cnxtech/TCDeadTimeDriver/README.md

# TCDeadTimeDriver

This repository contains a custom add-on circuit for the [oneTesla v1 Musical Tesla Coil](http://onetesla.com/) to add a Dead-Time between the gate pulses to the IGBT driver transistors to minimize overlap and prevent premature death of the transistors.
