cnxtech/TCDeadTimeDriver/PWMMainDriver.pdf

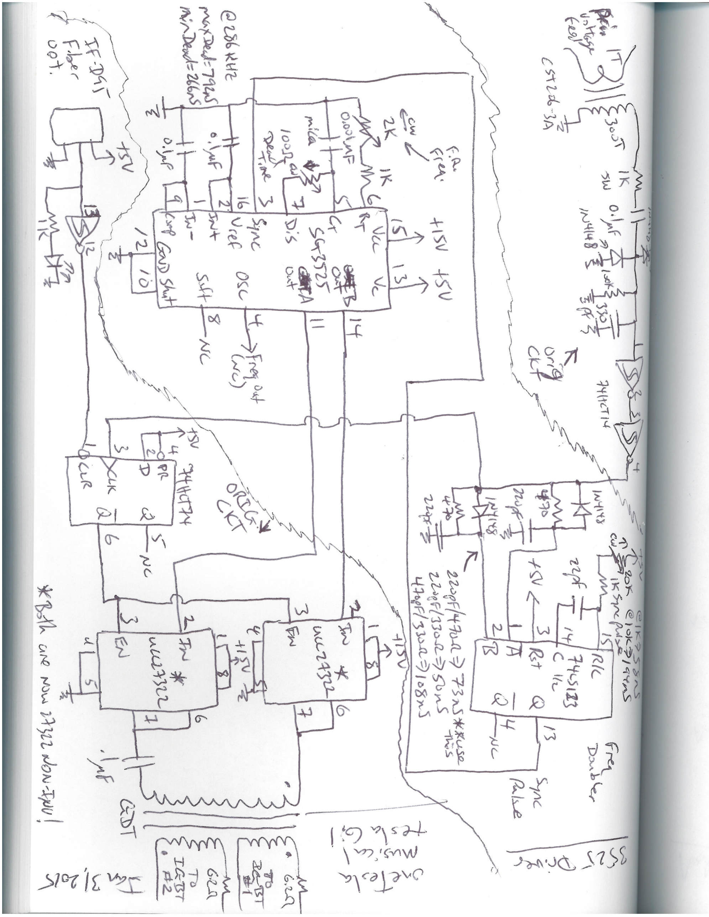
[picture p1: page 1]
