cnxtech/TCDeadTimeDriver/TCDeadTimeDriver-V1/preview/TCDeadTimeDriver-V1-00a-BoardTop.png

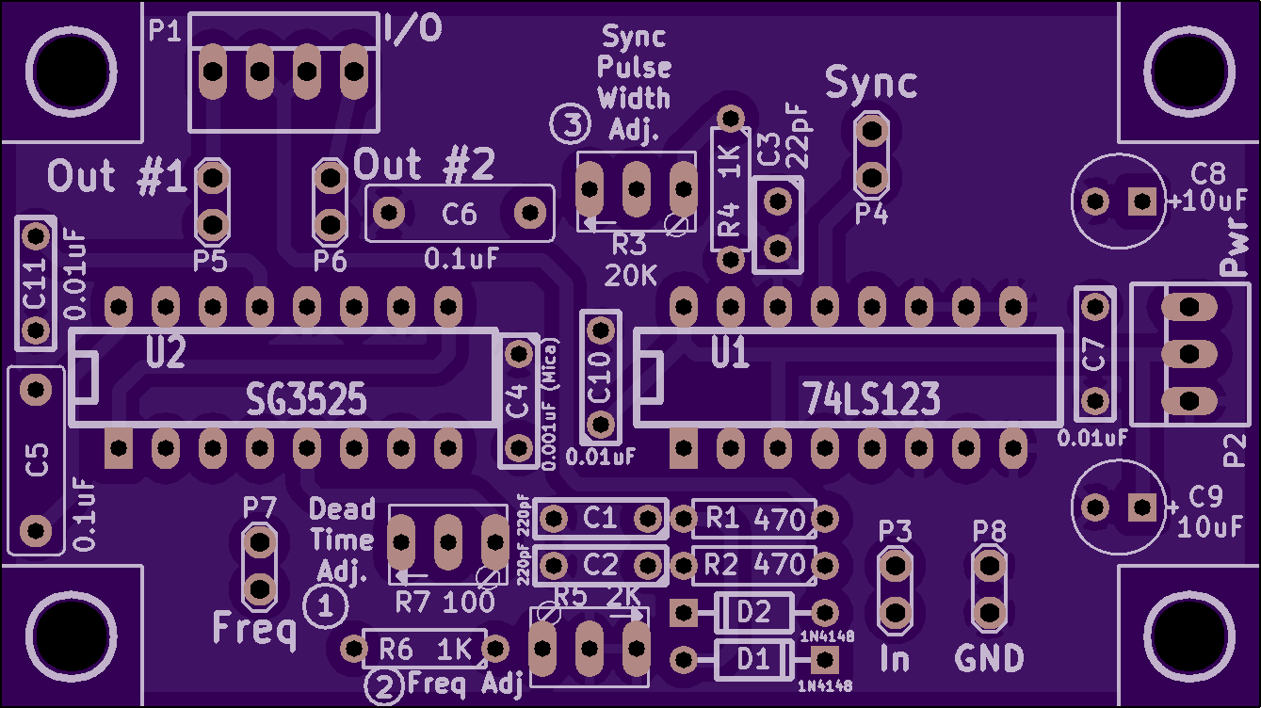
TCDeadTimeDriver-V1/preview/TCDeadTimeDriver-V1-00a-BoardTop.png
