cnxtech/TCDeadTimeDriver/TCDeadTimeDriver-V1/preview/TCDeadTimeDriver-V1-00b-BoardBottom.png

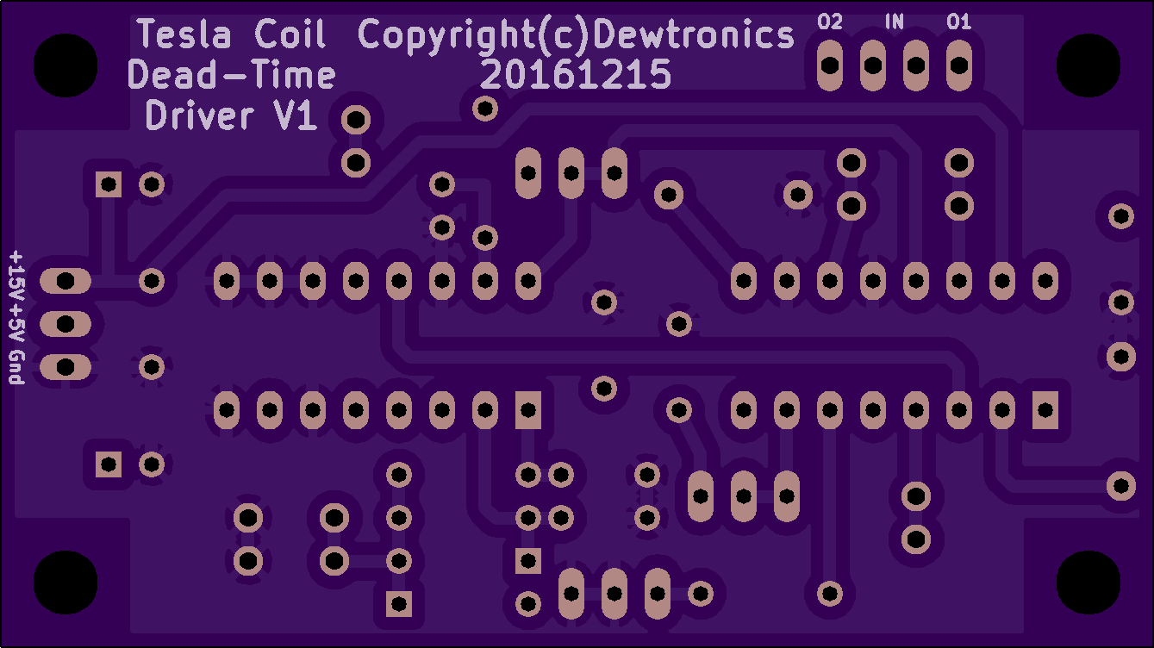
TCDeadTimeDriver-V1/preview/TCDeadTimeDriver-V1-00b-BoardBottom.png
