cnxtech/TCDeadTimeDriver/TCDeadTimeDriver-V1/preview/TCDeadTimeDriver-V1-03-TopSilkScreen.png

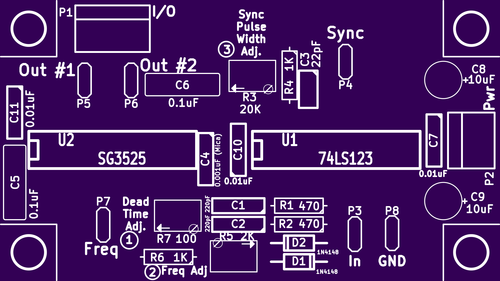
TCDeadTimeDriver-V1/preview/TCDeadTimeDriver-V1-03-TopSilkScreen.png
