cnxtech/TCDeadTimeDriver/TCDeadTimeDriver-V1/preview/TCDeadTimeDriver-V1-04-BottomSilkScreen.png

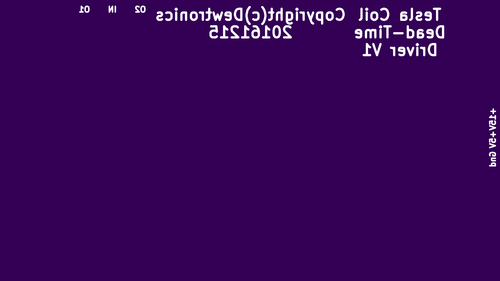
TCDeadTimeDriver-V1/preview/TCDeadTimeDriver-V1-04-BottomSilkScreen.png
