cnxtech/TCDeadTimeDriver/TCDeadTimeDriver-V1/preview/TCDeadTimeDriver-V1-05-Drills.png

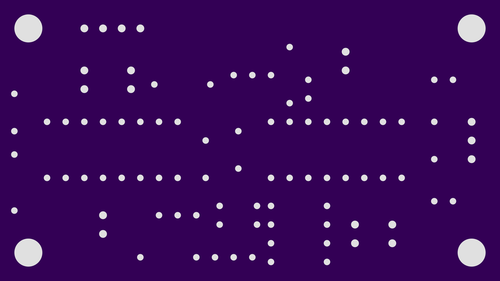
TCDeadTimeDriver-V1/preview/TCDeadTimeDriver-V1-05-Drills.png
