cnxtech/TCDeadTimeDriver/TCDeadTimeDriver-V1/preview/TCDeadTimeDriver-V1-06-TopLayer.png

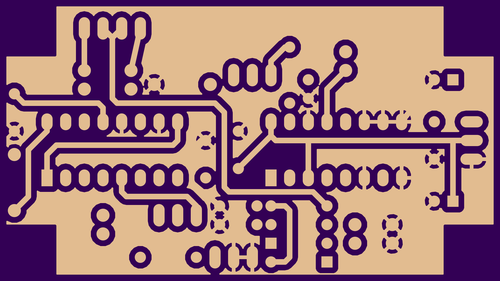
TCDeadTimeDriver-V1/preview/TCDeadTimeDriver-V1-06-TopLayer.png
