cnxtech/TCDeadTimeDriver/TCDeadTimeDriver-V1/preview/TCDeadTimeDriver-V1-07-BottomLayer.png

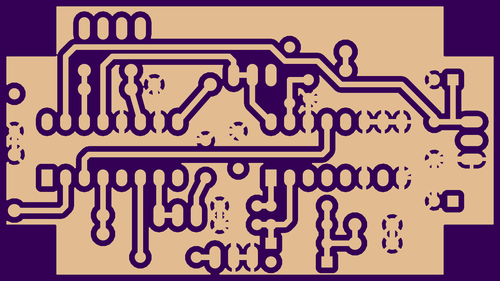
TCDeadTimeDriver-V1/preview/TCDeadTimeDriver-V1-07-BottomLayer.png
