cnxtech/TCDeadTimeDriver/TCDeadTimeDriver-V1/preview/TCDeadTimeDriver-V1-08-BoardOutline.png

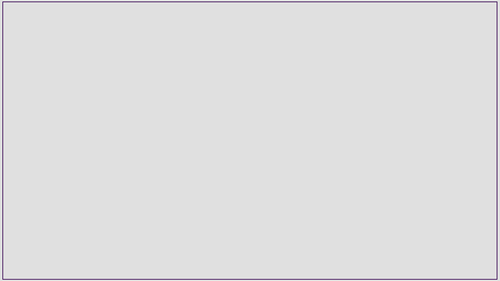
TCDeadTimeDriver-V1/preview/TCDeadTimeDriver-V1-08-BoardOutline.png
