cnxtech/TCDeadTimeDriver/TCDeadTimeDriver-V1/TCDeadTimeDriver-V1.png

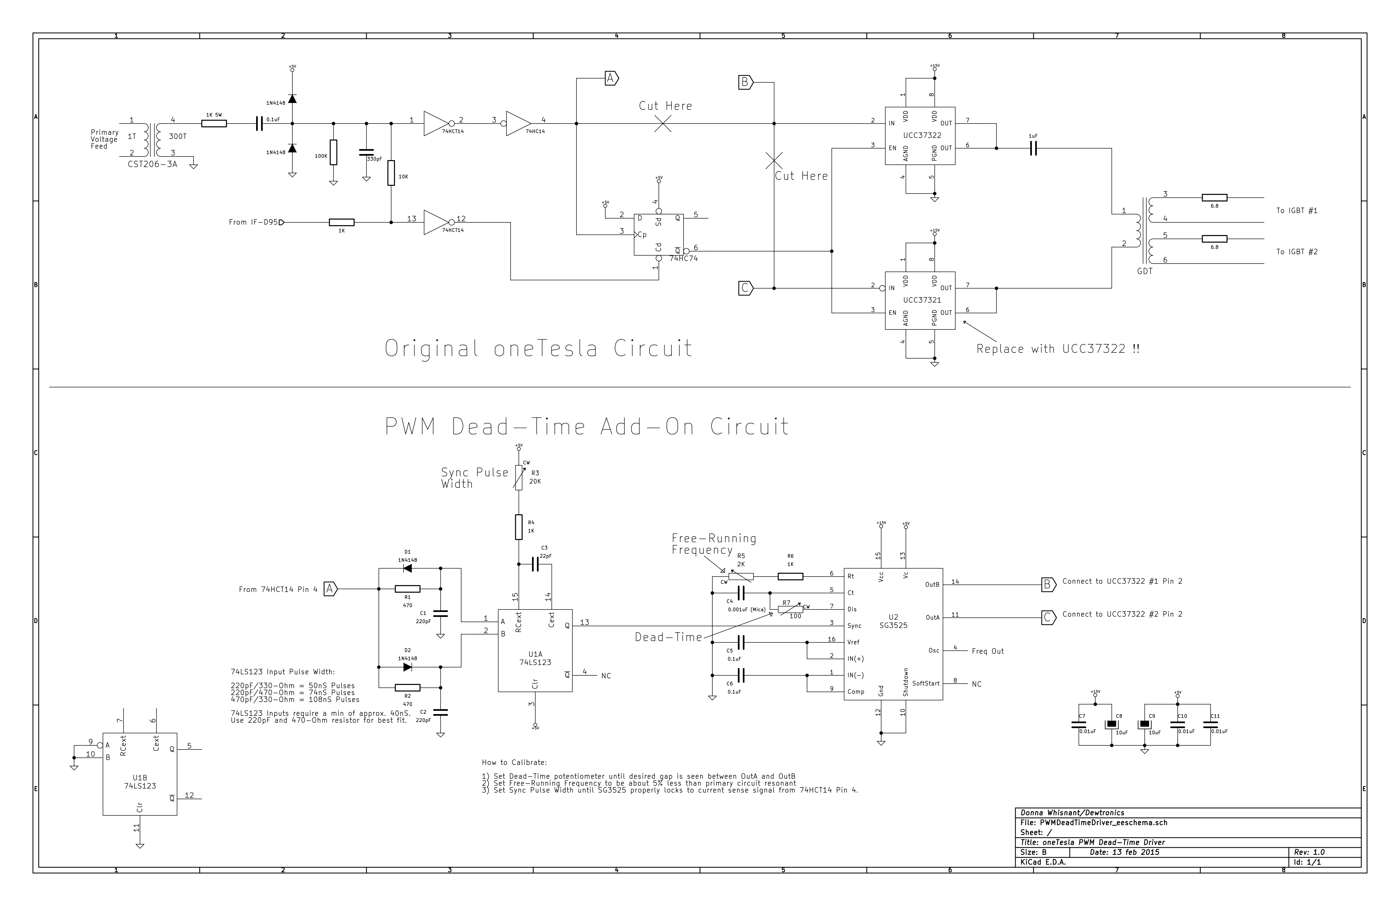
TCDeadTimeDriver-V1/TCDeadTimeDriver-V1.png
