cnxtech/TCDeadTimeDriver/PWMDeadTimeDriver.pdf

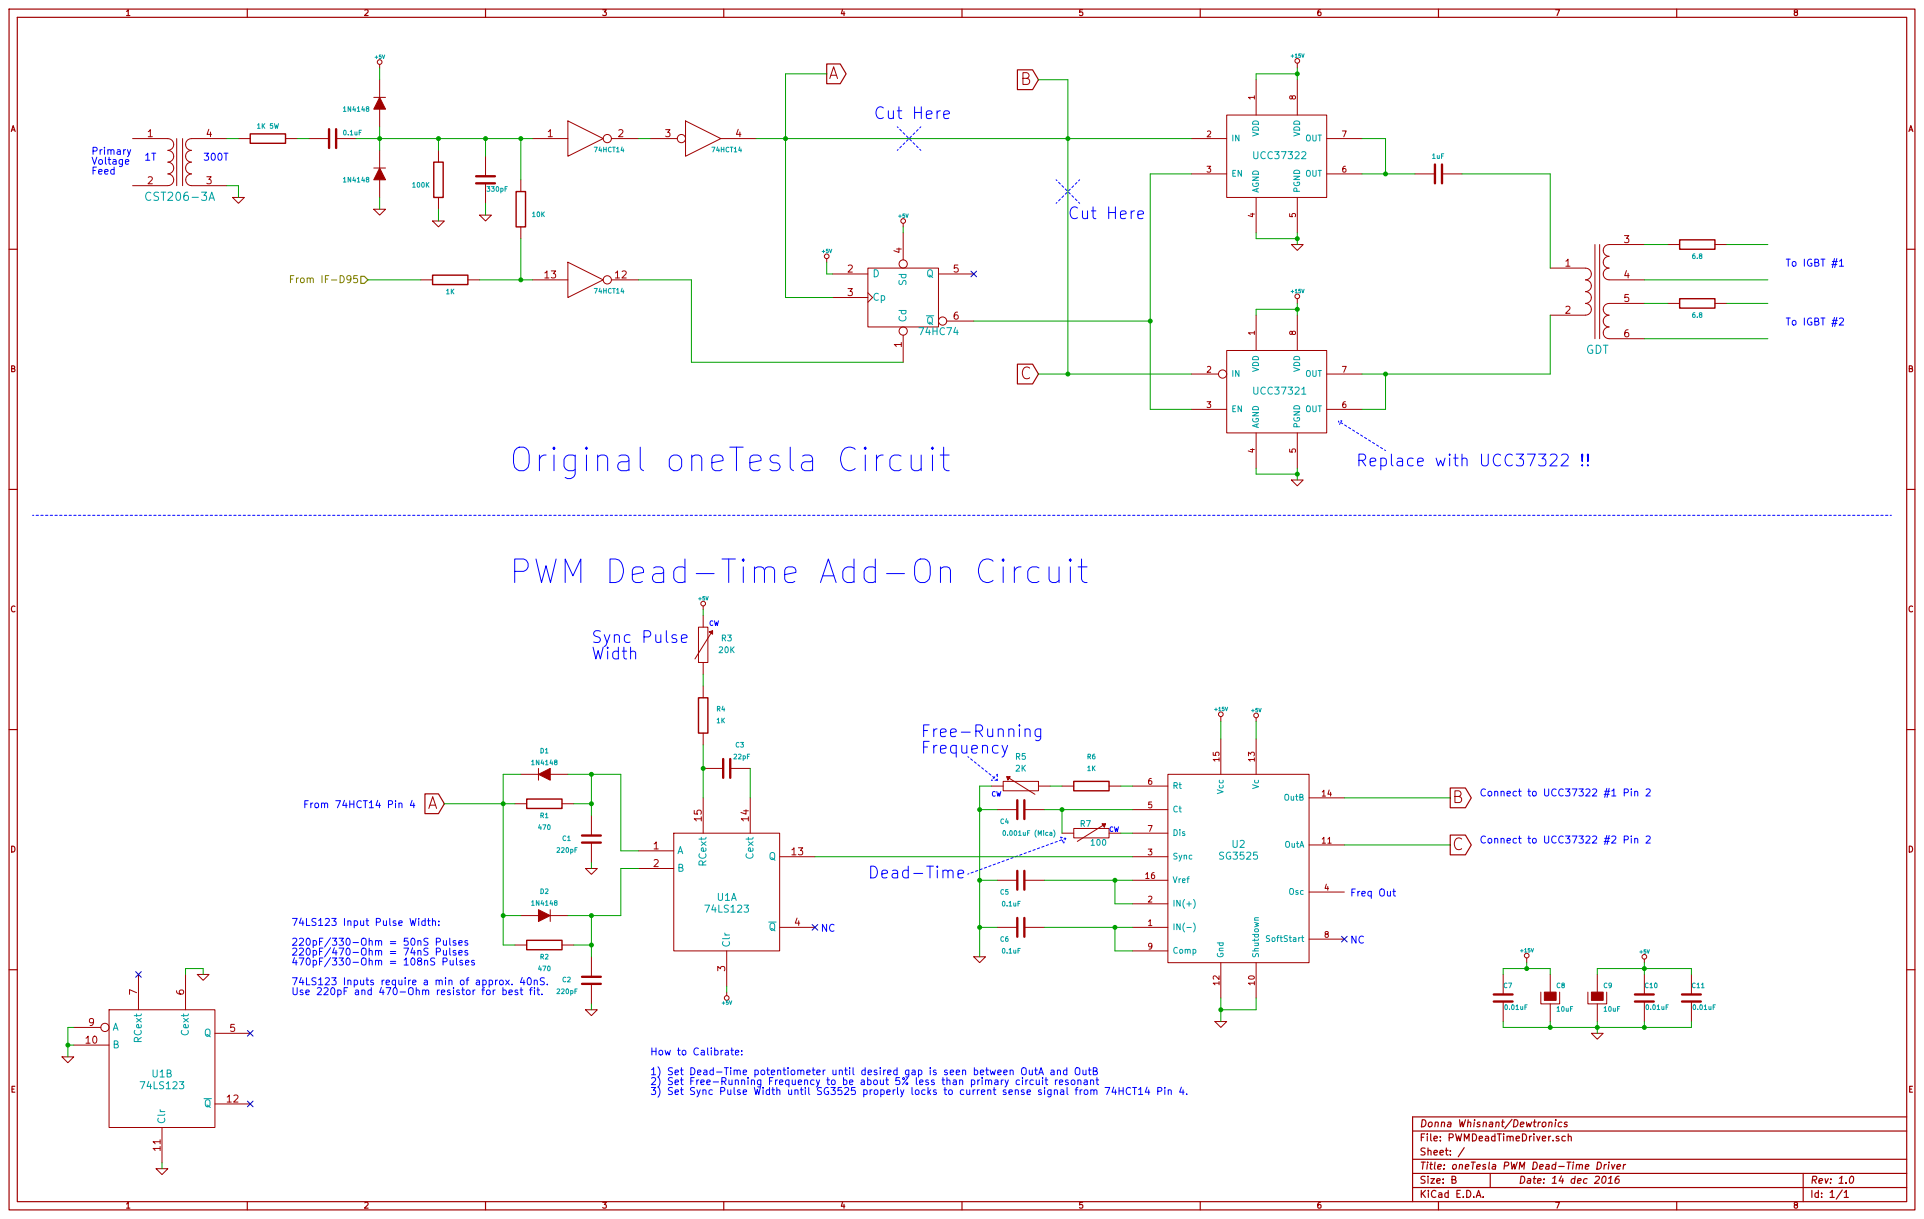
[picture p11: page 1]

PWM Dead-Time Add-On Circuit

+5V 74LS123 Input Pulse Width:
220pF/330-Ohm = 50nS Pulses
220pF/470-Ohm = 74nS Pulses
470pF/330-Ohm = 108nS Pulses
74LS123 Inputs require a min of approx. 40nS.
Use 220pF and 470-Ohm resistor for best fit.

How to Calibrate:
1) Set Dead-Time potentiometer until desired gap is seen between OutA and OutB
2) Set Free-Running Frequency to be about 5% less than primary circuit resonant
3) Set Sync Pulse Width until SG3525 properly locks to current sense signal from 74HCT14 Pin 4.

Id: 1/1 Title: oneTesla PWM Dead-Time Driver File: PWMDeadTimeDriver.sch Sheet: /
