cnxtech/TCDeadTimeDriver/TCDeadTimeDriver-V1/TCDeadTimeDriver-V1.kicad_pcb

## KiCad design TCDeadTimeDriver-V1/TCDeadTimeDriver-V1.kicad_pcb (2016-12-17)

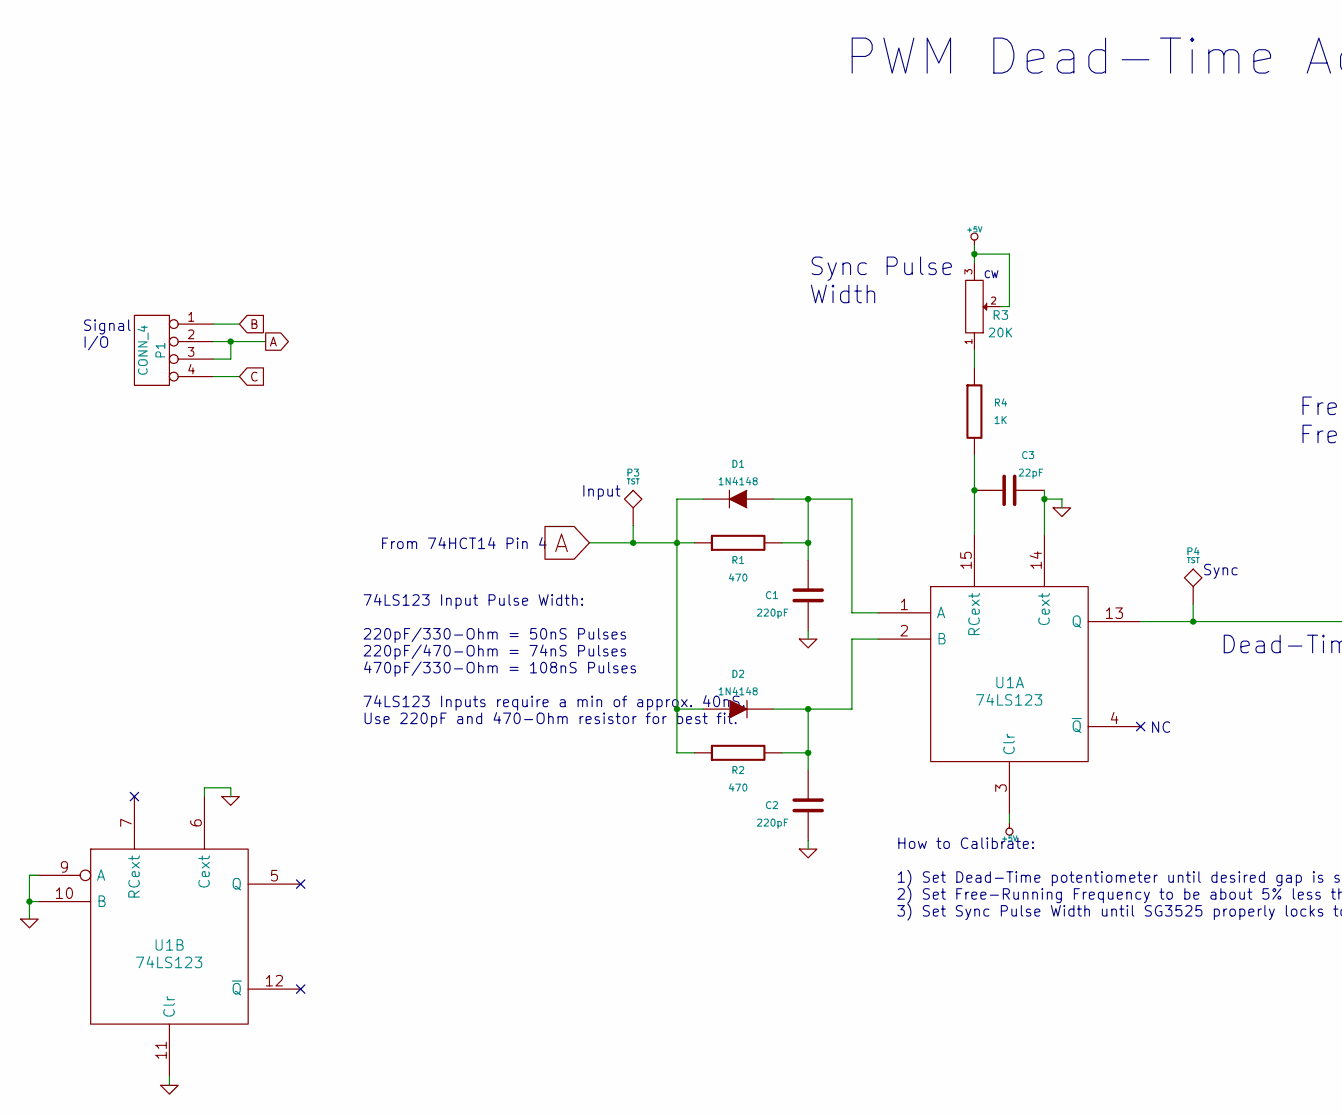
[picture p12: schematic TCDeadTimeDriver-V1.sch, oneTesla PWM Dead-Time Driver, part in row 1, column 1]

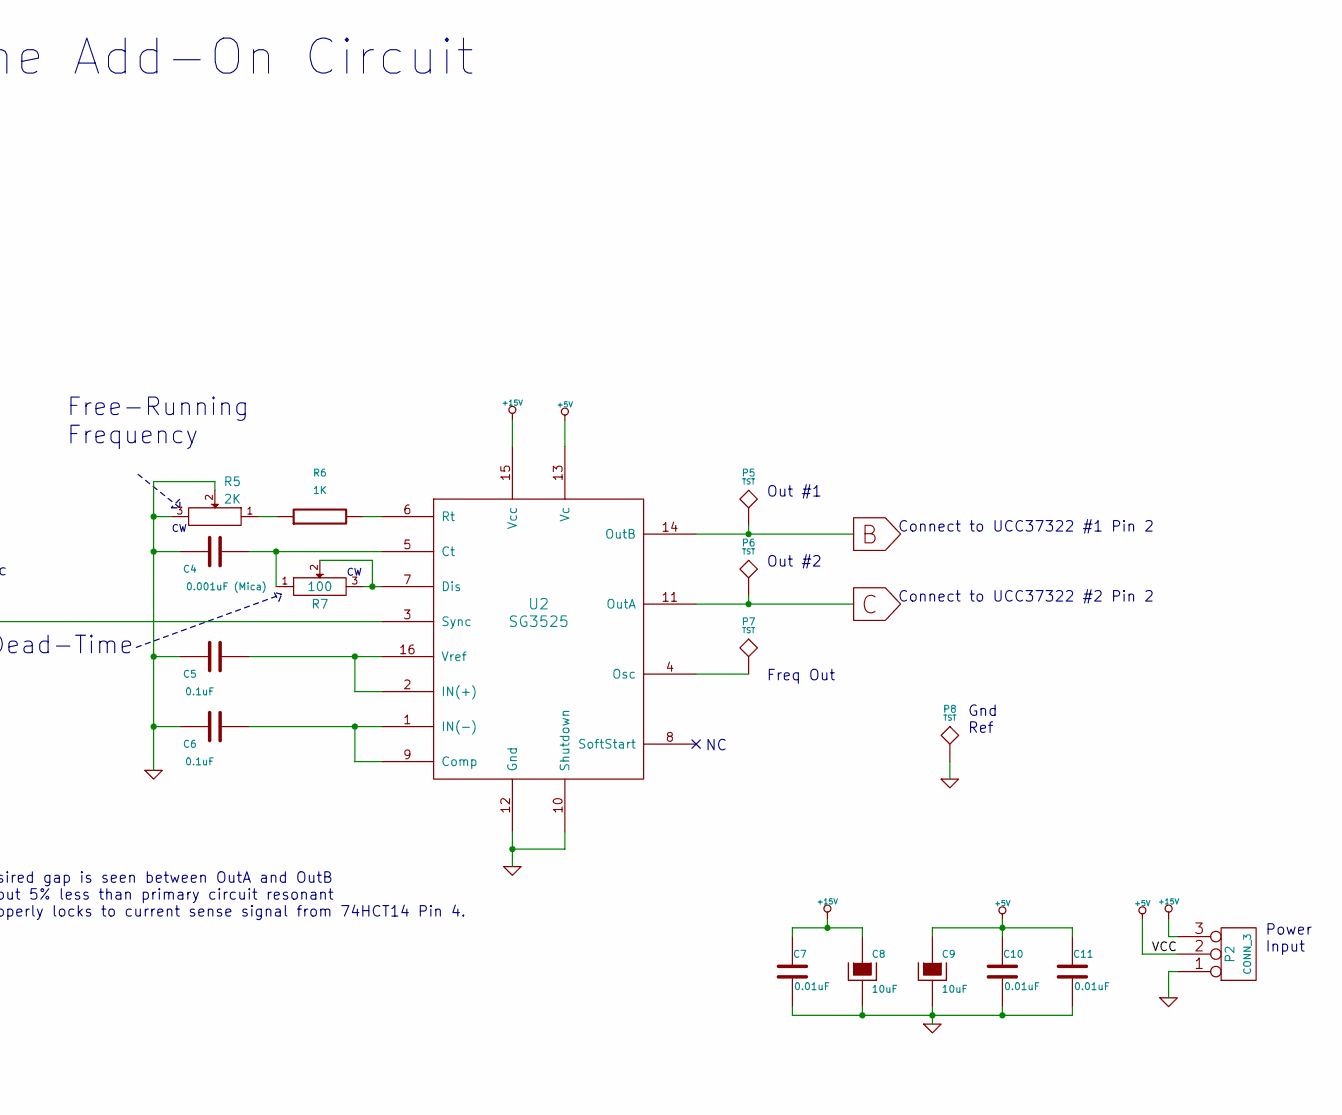
[picture p13: schematic TCDeadTimeDriver-V1.sch, oneTesla PWM Dead-Time Driver, part in row 1, column 2]

Parts:
C1, C2: 220pF
C3: 22pF
C4: 0.001uF (Mica)
C5, C6: 0.1uF
C7, C10, C11: 0.01uF
C8, C9: 10uF
D1, D2: 1N4148
P1: CONN_4
P2: CONN_3
P3, P4, P5, P6, P7, P8: TST
R1, R2: 470
R3: 20K
R4, R6: 1K
R5: 2K
R7: 100
U1: 74LS123
U2: SG3525

Connections:
+5V: C9.1, C10.1, C11.1, P2.2 (PM), R3.2, R3.3, U1.3 (Clr), U1.16 (VCC), U2.13 (Vc)
+15V: C7.1, C8.1, P2.3, U2.15 (Vcc)
A: D1.2 (K), D2.1 (A), P1.2, P1.3, P3.1, R1.1, R2.1
B: P1.1, P5.1, U2.14 (OutB)
C: P1.4, P6.1, U2.11 (OutA)
GND: C1.2, C2.2, C3.2, C4.1, C5.1, C6.1, C7.2, C8.2, C9.2, C10.2, C11.2, P2.1, P8.1, R5.2, R5.3, U1.6 (Cext), U1.8 (GND), U1.9 (A), U1.10 (B), U1.11 (Clr), U1.14 (Cext), U2.10 (Shutdown), U2.12 (Gnd)
unnamed: R6.2, U2.6 (Rt)
unnamed: R5.1, R6.1
unnamed: C4.2, R7.1, U2.5 (Ct)
unnamed: R3.1, R4.1
unnamed: C6.2, U2.1 (IN(-)), U2.9 (Comp)
unnamed: C5.2, U2.2 (IN(+)), U2.16 (Vref)
unnamed: P4.1, U1.13 (Q), U2.3 (Sync)
unnamed: C2.1, D2.2 (K), R2.2, U1.2 (B)
unnamed: C1.1, D1.1 (A), R1.2, U1.1 (A)
unnamed: P7.1, U2.4 (Osc)
unnamed: R7.2, R7.3, U2.7 (Dis)
unnamed: C3.1, R4.2, U1.15 (RCext)

Notes on the sheet:
Sync Pulse Width
Free-Running Frequency
Dead-Time
74LS123 Input Pulse Width: 220pF/330-Ohm = 50nS Pulses 220pF/470-Ohm = 74nS Pulses 470pF/330-Ohm = 108nS Pulses 74LS123 Inputs require a min of approx. 40nS. Use 220pF and 470-Ohm resistor for best fit.
Freq Out
From 74HCT14 Pin 4
Connect to UCC37322 #1 Pin 2
Connect to UCC37322 #2 Pin 2
PWM Dead-Time Add-On Circuit
How to Calibrate: 1) Set Dead-Time potentiometer until desired gap is seen between OutA and OutB 2) Set Free-Running Frequency to be about 5% less than primary circuit resonant 3) Set Sync Pulse Width until SG3525 properly locks to current sense signal from 74HCT14 Pin 4.
Power Input
Signal I/O
Sync
Input
Out #1
Out #2
Gnd Ref

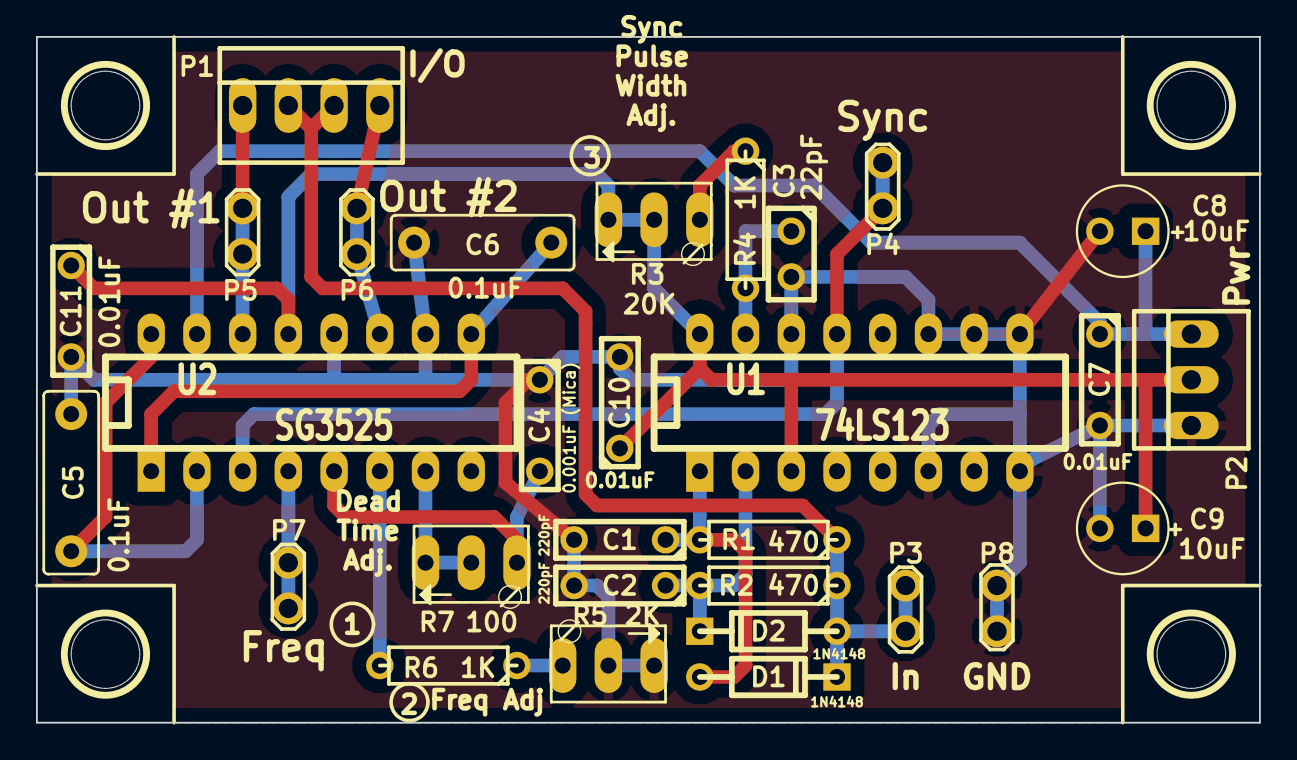
[picture p14: board TCDeadTimeDriver-V1.kicad_pcb from above]

Board: 2 copper layers, 67.9 x 38.1 mm, 34 parts (0 on the bottom side), 18 nets.

Other parts of the board:
1PIN, 1PIN#2, 1PIN#3, 1PIN#4: P***; 1pin
