cnxtech/TCDeadTimeDriver/TCDeadTimeDriver-V1/preview/TCDeadTimeDriver-V1-09-TopSolderMask.png

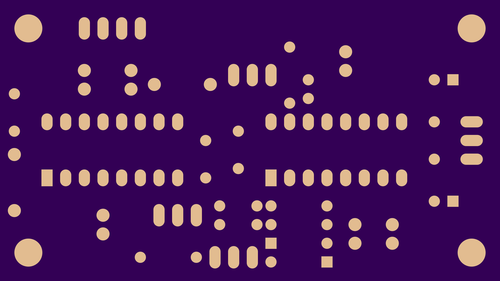
TCDeadTimeDriver-V1/preview/TCDeadTimeDriver-V1-09-TopSolderMask.png
