cnxtech/TCDeadTimeDriver/(notices)

Notices in the files:
TCDeadTimeDriver-V1/TCDeadTimeDriver-V1.kicad_pcb:
Copyright(c)Dewtronics
